planmarks/Splunkerboard/Splunker 1/3D/Render.png

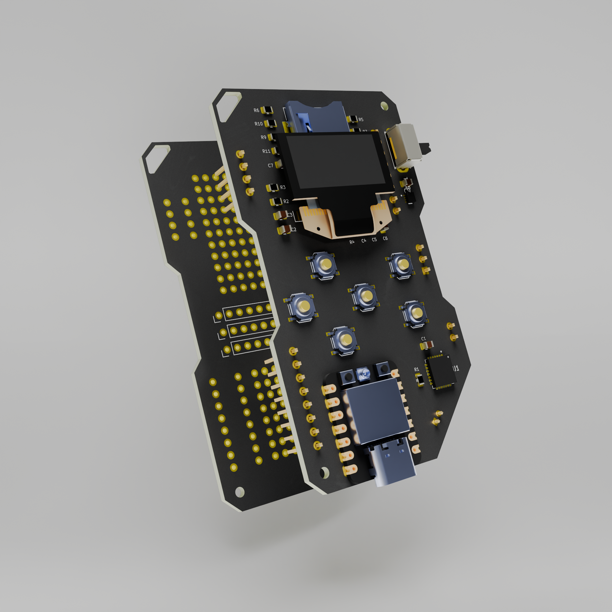
Splunker 1/3D/Render.png
