planmarks/Splunkerboard/Splunker 1/Pictures/Splunkerboard-1-1x1.jpg

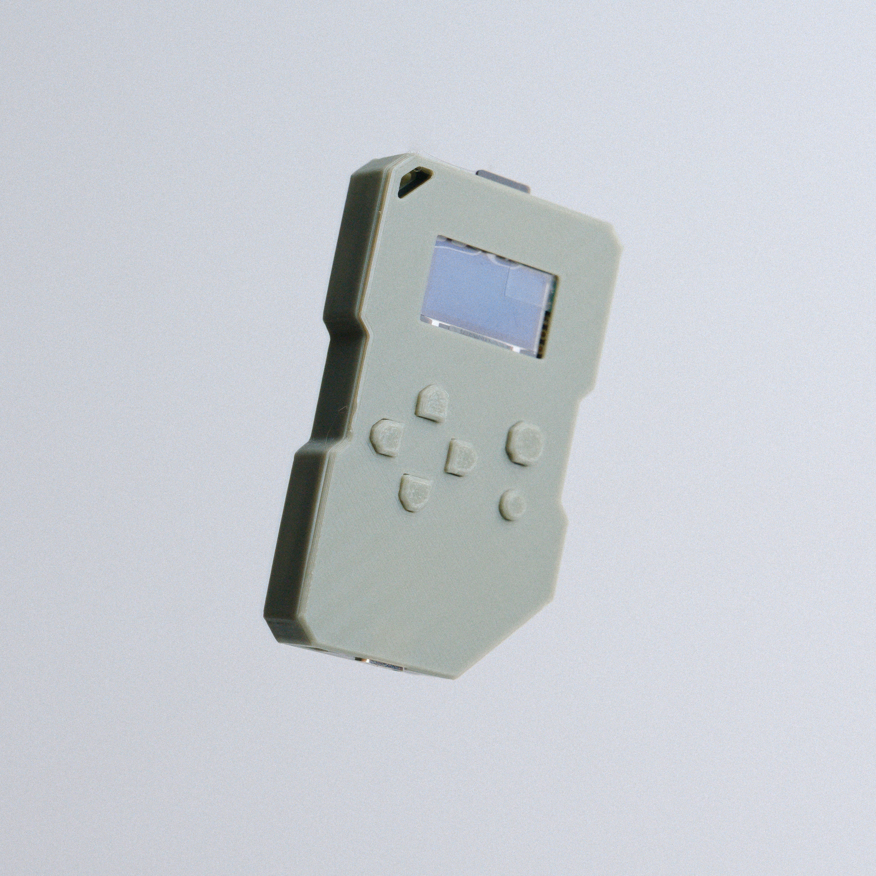
Splunker 1/Pictures/Splunkerboard-1-1x1.jpg
