planmarks/Splunkerboard/Splunker 1/Pictures/splunkerboard-back-1x1.jpg

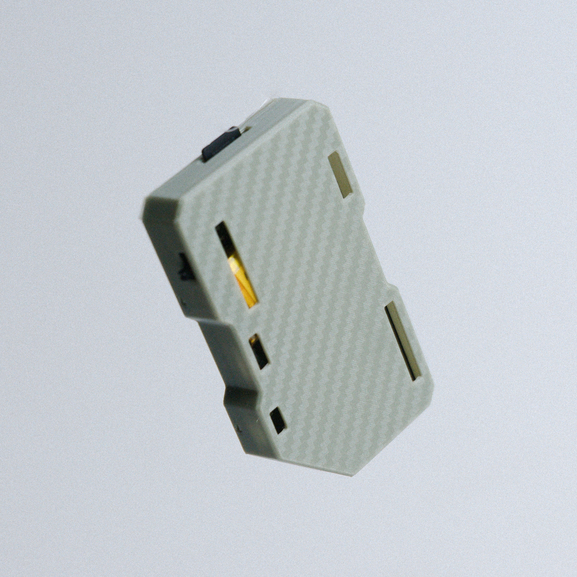
Splunker 1/Pictures/splunkerboard-back-1x1.jpg
