planmarks/Splunkerboard/Splunker 1/Pictures/Splunkerboard-inhand.jpg

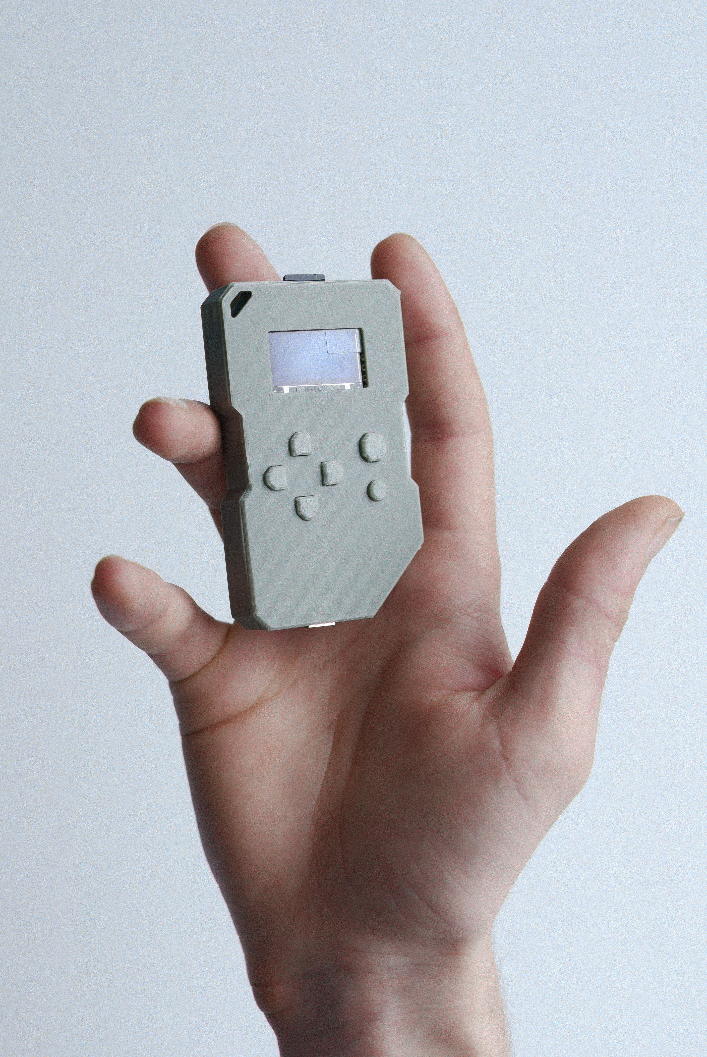
Splunker 1/Pictures/Splunkerboard-inhand.jpg
