planmarks/Splunkerboard/Splunker 1/Pictures/Splunkerboard-naked1x1.jpg

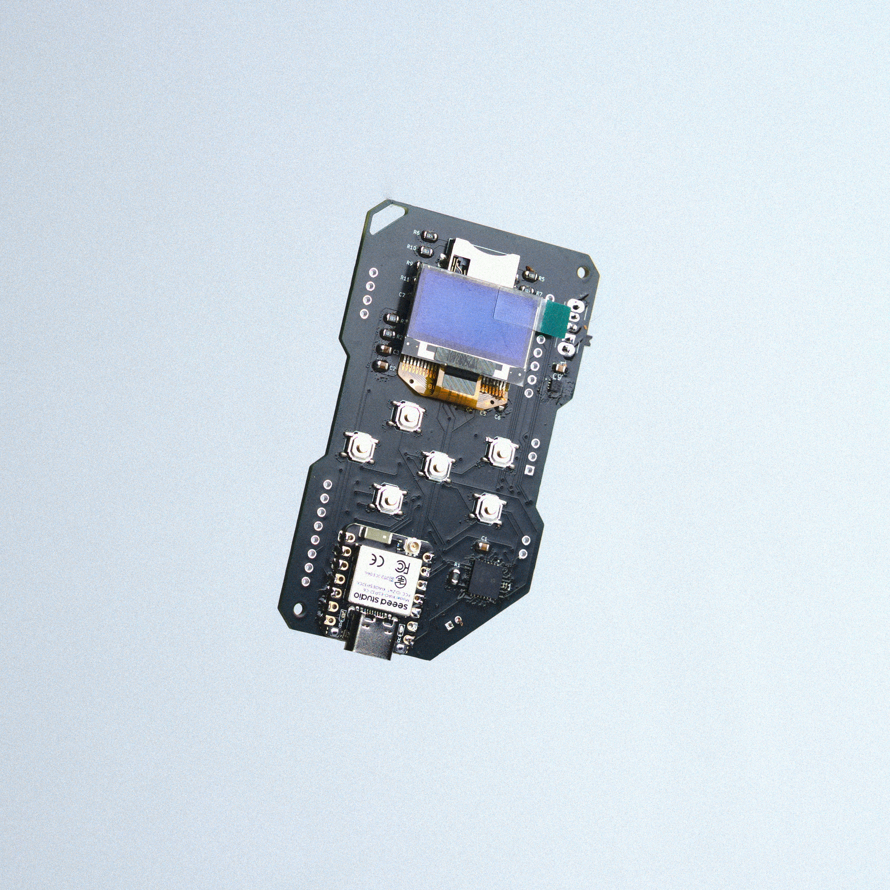
Splunker 1/Pictures/Splunkerboard-naked1x1.jpg
