planmarks/Splunkerboard/Splunker 1/Pictures/Splunkerboard-naked.jpg

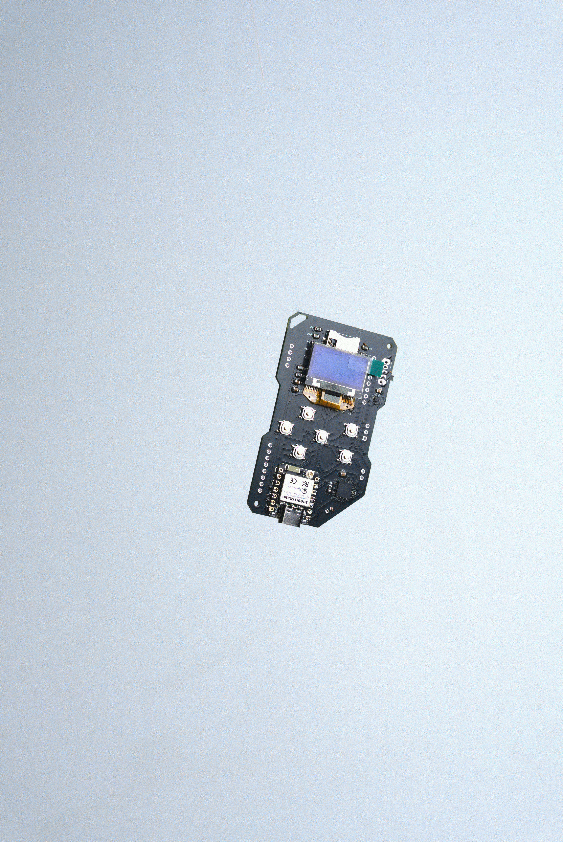
Splunker 1/Pictures/Splunkerboard-naked.jpg
