planmarks/Splunkerboard/Splunker 1/Pictures/Splunkerboard-with-addon1x1.jpg

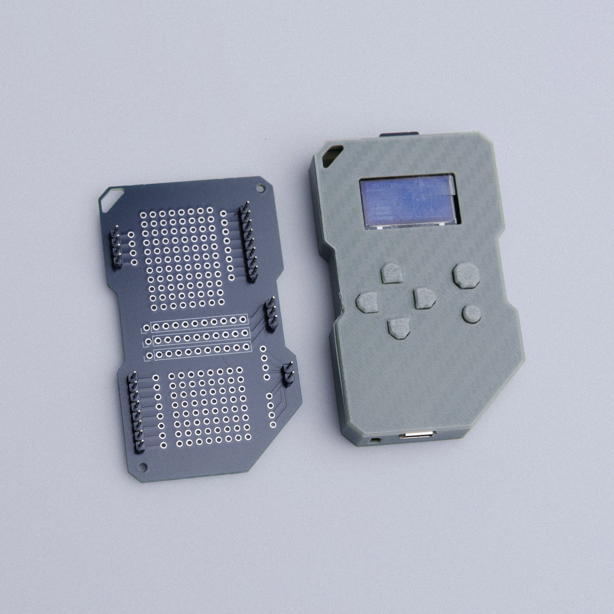
Splunker 1/Pictures/Splunkerboard-with-addon1x1.jpg
