planmarks/Splunkerboard/Splunkerboard DIY/Pictures/Splunkerboard-DIY-2.jpg

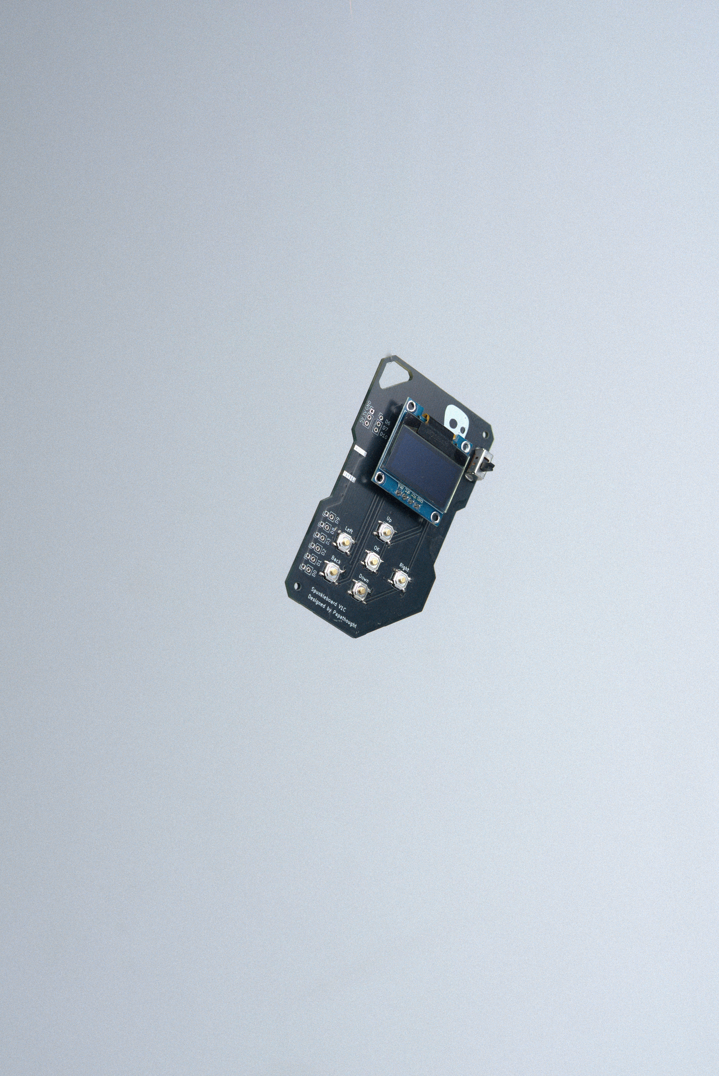
Splunkerboard DIY/Pictures/Splunkerboard-DIY-2.jpg
