planmarks/Splunkerboard/Splunker 1/BOM/Muru Product Compliance - Splunkerboard 1.csv

Reference | Qty | Part nr. / Value | MPN | Footprint | Buy Link 1 | Buy Link 2 | Datasheet | RoHS Comp | RoHS Docs | EMC Test link | CPU | Total Cost
unmarked | 1 | Seeed XIAO ESP32‑C5 | 100010048 |  | https://www.digikey.ee/en/products/detail/seeed-technology-co-ltd/100010048/28959910 |  | https://files.seeedstudio.com/Bazaar/product_pdf/100010048.pdf | ROHS3 Compliant | https://files.seeedstudio.com/Seeed_Certificate/documents_certificate/100010048-ROHS.pdf |  | €6.06 | €6.06
U1 | 1 | MCP23017-EML | MCP23017-E/ML | 28-VQFN Exposed Pad | https://www.digikey.ee/en/products/detail/microchip-technology/MCP23017-E-ML/894270 |  | https://ww1.microchip.com/downloads/aemDocuments/documents/APID/ProductDocuments/DataSheets/MCP23017-Data-Sheet-DS20001952.pdf | ROHS3 Compliant | https://ww1.microchip.com/downloads/aemDocuments/documents/corporate-responsibilty/environmental/product-regulatory-information/Semiconductor_EnvCoC.pdf |  | €1.67 | €1.67
DS1 | 1 | OLED-128O064D | DLC0096DNOG-W-5 |  | https://www.digikey.ee/en/products/detail/dlc-display-co-ltd/dlc0096dnog-w-5/13624832 |  | https://www.dlcdisplay.com/viewfilebizce/1760131013944299520/DLC0096DNOG-W-5.pdf | RoHS Compliant | No public RoHS doc found - request from DLC Display |  | €18.48 | €18.48
J26 | 1 | MicroSD MSD-11-A | MSD-11-A | 10 (8 + 2) | https://www.digikey.ee/en/products/detail/same-sky-formerly-cui-devices/msd-11-a/21798680 |  | https://www.sameskydevices.com/product/resource/msd-11-a.pdf | RoHS Compliant | https://www.sameskydevices.com/product/resource/material-compliance/msd-11-a |  | €0.37 | €0.37
SW2-SW7 | 1 | XKB TS‑1187A tactile switch | PTS526SK15SMTR2 LFS |  | https://www.digikey.ee/en/products/detail/c-k/PTS526SK15SMTR2-LFS/10056626 |  | https://www.littelfuse.com/assetdocs/littelfuse-c-k-tactile-pts526-series-datasheet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 | ROHS3 Compliant | https://www.littelfuse.com/assetdocs/coc-rohs10-08-18-2022?assetguid=6d7cc3c6-97e3-4940-98fc-322868282297 |  | €0.14 | €0.14
SW1 | 1 | CK OS102011MA1Q SPDT slide | OS102011MS2QN1 |  | https://www.digikey.ee/en/products/detail/c-k/OS102011MS2QN1/411602 |  | https://www.littelfuse.com/assetdocs/littelfuse-c-k-slide-os-series-datasheet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 | ROHS3 Compliant | https://www.littelfuse.com/assetdocs/coc-rohs10-08-18-2022?assetguid=6d7cc3c6-97e3-4940-98fc-322868282297 |  | €0.70 | €0.70
U3 | 1 | MAX17048G+T10 | MAX17048G+T10 | 8-WFDFN Exposed Pad | https://www.digikey.ee/en/products/detail/analog-devices-inc-maxim-integrated/MAX17048G-T10/3758921 |  | https://www.analog.com/media/en/technical-documentation/data-sheets/MAX17048-MAX17049.pdf | ROHS3 Compliant | https://www.maximintegrated.com/content/dam/files/design/emmi/rohs-certificate-of-compliance.pdf |  | €4.05 | €4.05
R1 | 1 | 10 K | RMCF0805FT10K0 | 805 | https://www.digikey.ee/en/products/detail/stackpole-electronics-inc/RMCF0805FT10K0/1760676 |  | https://www.seielect.com/catalog/SEI-RMCF_RMCP.pdff | ROHS3 Compliant | https://www.seielect.com/catalog/SEI-RoHS_Compliance_Status.pdf |  | €0.09 | €0.09
R2, R3, R5, R6, R7, R8, R9, R10, R11 | 9 | 4.7 K | RC0805FR-074K7L | 805 | https://www.digikey.ee/en/products/detail/yageo/RC0805FR-074K7L/727929 |  | https://yageogroup.com/content/datasheet/asset/file/PYU-RC_GROUP_51_ROHS_L | ROHS3 Compliant | https://yageogroup.com/content/Resource%20Library/Product%20Environmental%20Compliance/RoHS_Compliance_YAGEO.pdf |  | €0.09 | €0.81
R4 | 1 | 390 K | RC0805JR-07390KL | 805 | https://www.digikey.ee/en/products/detail/yageo/RC0805JR-07390KL/728320 |  | https://yageogroup.com/content/datasheet/asset/file/PYU-RC_GROUP_51_ROHS_L | ROHS3 Compliant | https://yageogroup.com/content/Resource%20Library/Product%20Environmental%20Compliance/RoHS_Compliance_YAGEO.pdf |  | €0.09 | €0.09
C1, C8, C9 | 3 | 0.1 µF | C0805C104K5RACTU | 805 | https://www.digikey.ee/en/products/detail/kemet/C0805C104K5RACTU/411169 |  | https://yageogroup.com/content/datasheet/asset/file/KEM_C1002_X7R_SMD | ROHS3 Compliant | https://yageogroup.com/component-documentation/download/rohs/C0805C104K5RACTU.pdf |  | €0.16 | €0.48
C7 | 1 | 10 µF | C0805C106K8PACTU | 805 | https://www.digikey.ee/en/products/detail/kemet/C0805C106K8PACTU/1090830 |  | https://yageogroup.com/content/datasheet/asset/file/KEM_C1006_X5R_SMD | ROHS3 Compliant | https://yageogroup.com/component-documentation/download/rohs/C0805C106K8PACTU.pdf |  | €0.18 | €0.18
C2, C3, C6 | 3 | 2.2 µF | UMK212BB7225KG-T | 805 | https://www.digikey.ee/en/products/detail/taiyo-yuden/UMK212BB7225KG-T/3194965 | https://www.mouser.ee/en/ProductDetail/Walsin/0805B225K100CT | https://mm.digikey.com/Volume0/opasdata/d220001/medias/docus/992/UMK212BB7225KG-T_SS.pdf | ROHS3 Compliant | https://www.yuden.co.jp/en/product/certificate/upload/MLCC-RoHS.pdf |  | €0.28 | €0.84
C4 | 1 | 1 µF | CAP CER 10000PF 50V X7R 0603 | 805 | https://www.digikey.ee/en/products/detail/samsung-electro-mechanics/CL10B103KB8NNNC/3886667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 |  | https://mm.digikey.com/Volume0/opasdata/d220001/medias/docus/609/CL10B103KB8NNNC_Spec.pdf | ROHS3 Compliant | https://www.samsungsem.com/files/fileDown.do?key=ed1dfdfa-645e-4252-b707-17f9b1502dd1 |  | €0.09 | €0.09
C5 | 1 | 0.1 µF | C0805C104K5RACTU | 805 | https://www.digikey.ee/en/products/detail/kemet/C0805C104K5RACTU/411169 |  | https://yageogroup.com/content/datasheet/asset/file/KEM_C1002_X7R_SMD | ROHS3 Compliant | https://yageogroup.com/component-documentation/download/rohs/C0805C104K5RACTU.pdf |  | €0.16 | €0.16
 |  |  |  |  |  |  |  |  |  |  | €0.50 | €0.50
 |  |  |  |  |  |  |  |  |  |  | €5.00
 |  |  |  |  |  |  |  |  |  |  | Total | €34.71
