planmarks/Splunkerboard/Splunker 1 Prototyping Board/3D/Splunkerboard.stl

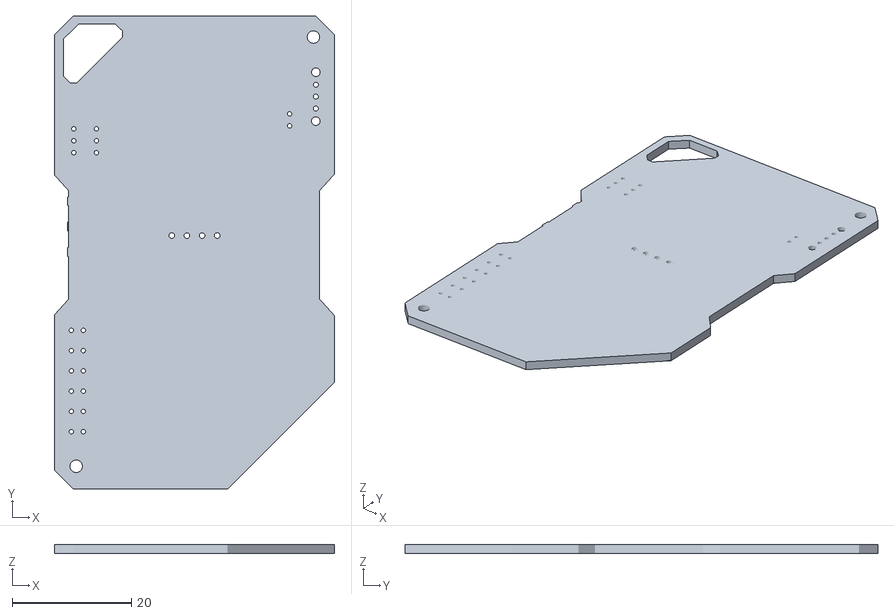
[picture p12: CAD file, 2026-10-02]
Splunker 1 Prototyping Board/3D/Splunkerboard.stl
47.0 x 79.3 x 1.66
