planmarks/Splunkerboard/Splunker 1/Case/v01/Splunkerboard CaseCylinder.stl

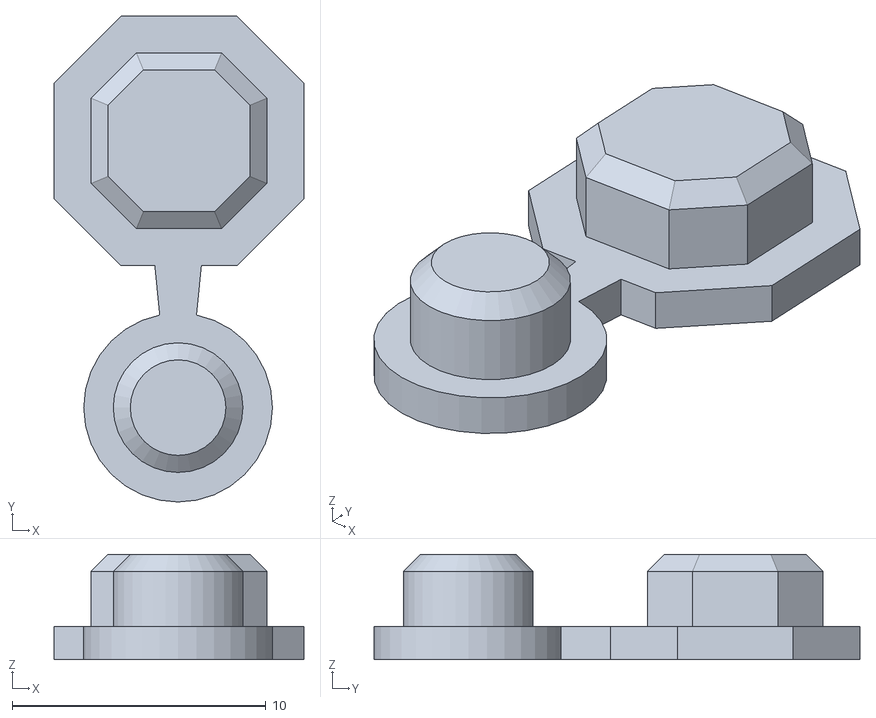
[picture p13: CAD file, 2026-10-26]
Splunker 1/Case/v01/Splunkerboard CaseCylinder.stl
9.83 x 19.1 x 4.15
