planmarks/Splunkerboard/Splunker 1/Case/v01/Splunkerboard CaseCase_Top.stl

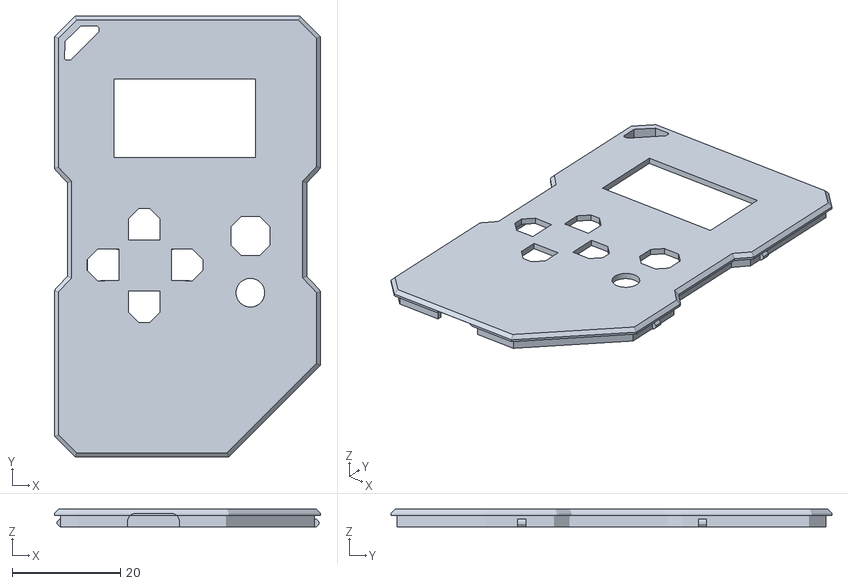
[picture p14: CAD file, 2026-10-26]
Splunker 1/Case/v01/Splunkerboard CaseCase_Top.stl
49.2 x 81.5 x 3.32
