planmarks/Splunkerboard/Splunker 1/Case/v01/Splunkerboard CaseCase_Bottom_Batter.stl

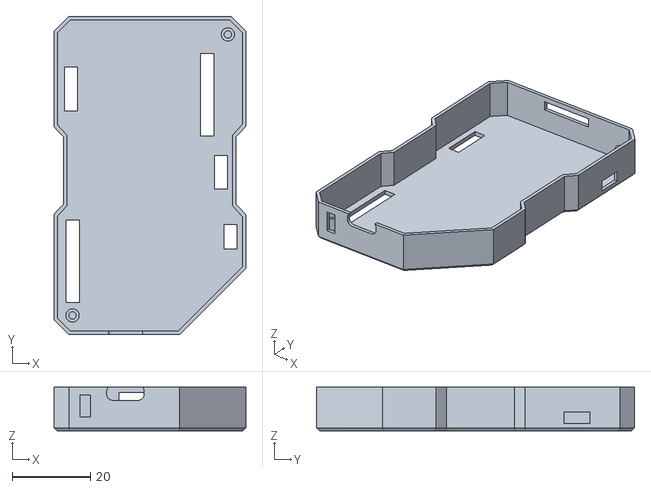
[picture p15: CAD file, 2026-10-26]
Splunker 1/Case/v01/Splunkerboard CaseCase_Bottom_Batter.stl
49.2 x 81.5 x 11.3
