planmarks/Splunkerboard/Splunker 1/Case/v01/Splunkerboard CaseCube.002.stl

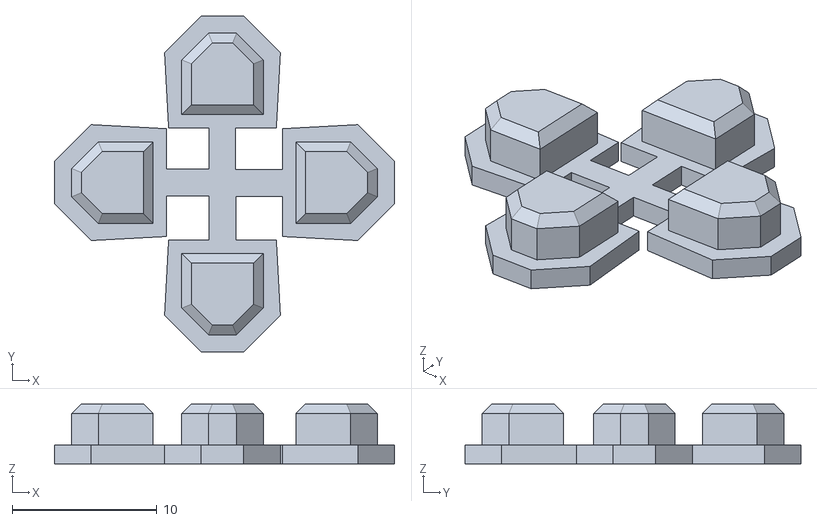
[picture p16: CAD file, 2026-10-26]
Splunker 1/Case/v01/Splunkerboard CaseCube.002.stl
23.5 x 23.2 x 4.15
