planmarks/Splunkerboard/(list of files, cad)

Other CAD files:
Splunker 1/3D/Splunkerboard Dev.stl
Splunker 1/Case/v0/Splunkerboard CaseCase_Bottom_Batter.stl
Splunker 1/Case/v0/Splunkerboard CaseCase_Top.stl
Splunker 1/3D/Spunkleboard 1 3D.blend
Splunker 1/Case/Splunkerboard Case.blend
