planmarks/Splunkerboard/Splunkerboard DIY/Spunkleboard.kicad_pcb

## KiCad design Splunkerboard DIY/Spunkleboard.kicad_pcb (2026-10-02)

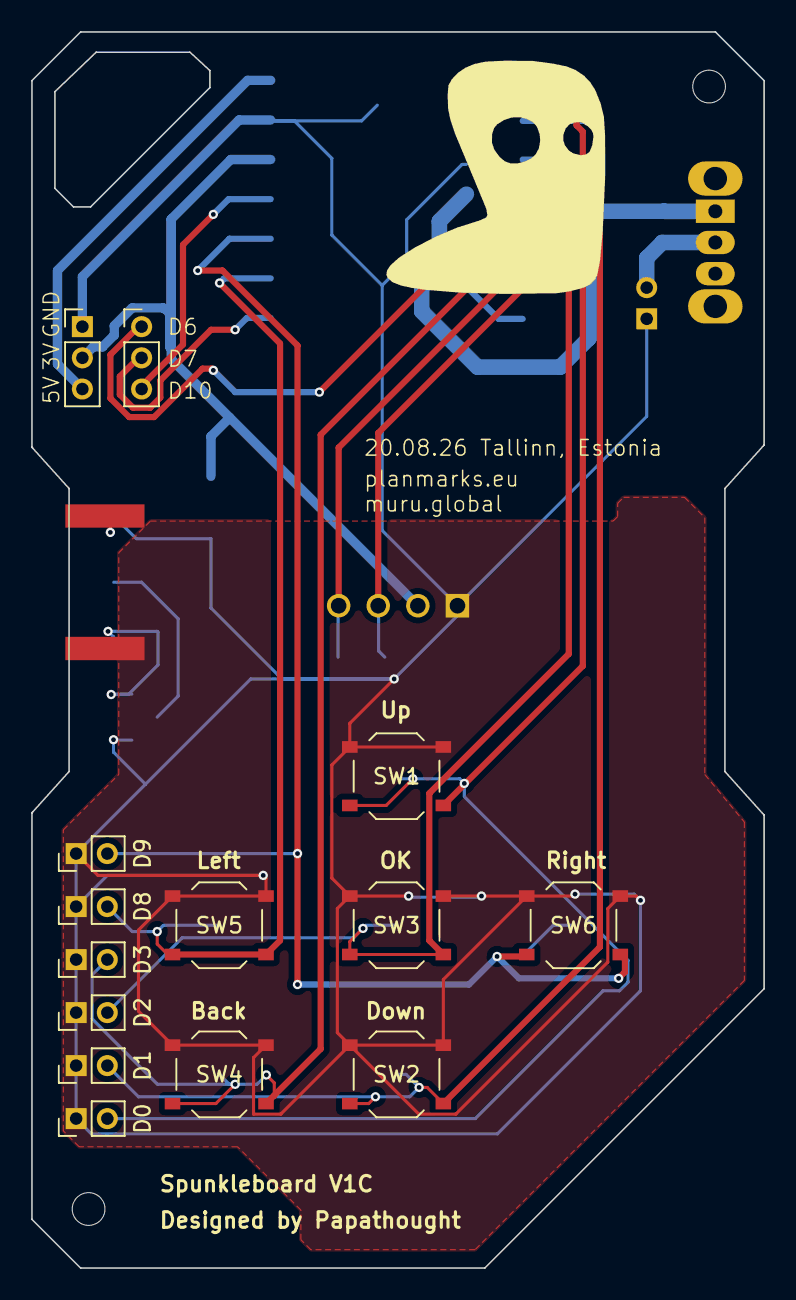
[picture p17: board Splunkerboard DIY/Spunkleboard.kicad_pcb from above]

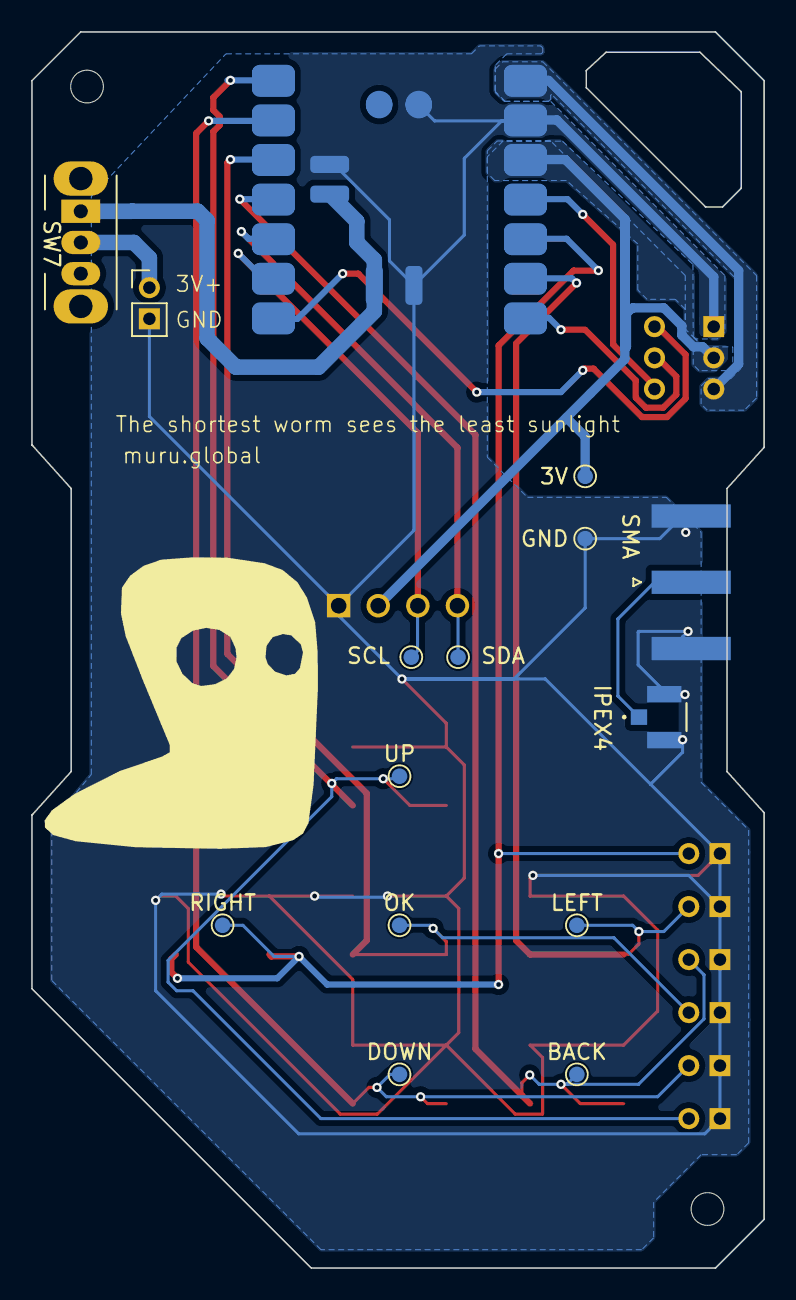
[picture p18: board Splunkerboard DIY/Spunkleboard.kicad_pcb from below]

Board: 2 copper layers, 47.0 x 79.3 mm, 31 parts (16 on the bottom side), 18 nets.

Parts:
3V: 3V3; TestPoint_Pad_D1.0mm
BACK: SW-BCK; TestPoint_Pad_D1.0mm
BT1: Battery; PinHeader_1x02_P2.00mm_Vertical
D0, D1, D2, D3, D8, D9: PinHeader_1x02_P2.00mm_Vertical
DOWN: SW-DWN; TestPoint_Pad_D1.0mm
GND: GND; TestPoint_Pad_D1.0mm
IPEX4: MHF_I_RECE_IPX; MHF I_RECE_IPX
LEFT: SW-LFT; TestPoint_Pad_D1.0mm
MNT: MountingHole_2.1mm
MNT#2: MountingHole_2.1mm
OK: SW-OK; TestPoint_Pad_D1.0mm
RIGHT: SW-RHT; TestPoint_Pad_D1.0mm
SCL: SCL; TestPoint_Pad_D1.0mm
SDA: SDA; TestPoint_Pad_D1.0mm
SMA: SMA_Amphenol_132289_EdgeMount
SW1: SW_Push UP; SW_Push_1P1T_XKB_TS-1187A
SW2: SW_Push DOWN; SW_Push_1P1T_XKB_TS-1187A
SW3: SW_Push OK; SW_Push_1P1T_XKB_TS-1187A
SW4: SW_Push BACK; SW_Push_1P1T_XKB_TS-1187A
SW5: SW_Push LEFT; SW_Push_1P1T_XKB_TS-1187A
SW6: SW_Push RIGHT; SW_Push_1P1T_XKB_TS-1187A
SW7: SW_SPDT; SW_Slide_SPDT_Angled_CK_OS102011MA1Q
U1: XIAO-ESP32-C5-SMD
U2: DM-OLED096-636; MODULE_DM-OLED096-636
U3: XIAO-ESP32-C3-SMD
UP: SW-UP; TestPoint_Pad_D1.0mm

Connections:
+3.3V: 3V.1 (1_1), U1.12 (3V3_OUT), U2.2 (VCC_IN), U3.12 (3V3_OUT)
BAT+: BT1.1 (+), SW7.2 (B)
D0-SW1: D0.2, SW1.2, U1.1 (D0), U3.1 (D0), UP.1 (1_1)
D1-SW2: D1.2, DOWN.1 (1_1), SW2.2, U1.2 (D1), U3.2 (D1)
D2-SW3: D2.2, OK.1 (1_1), SW3.2, U1.3 (D2), U3.3 (D2)
D3-SW4: BACK.1 (1_1), D3.2, SW4.2, U1.4 (D3), U3.4 (D3)
D4-SDA: SDA.1 (1_1), U1.5 (D4), U2.4 (SDA), U3.5 (D4)
D5-SCL: SCL.1 (1_1), U1.6 (D5), U2.3 (SCL), U3.6 (D5)
D6: U1.7 (D6), U3.7 (D6)
D7: U1.8 (D7), U3.8 (D7)
D8-SW5: D8.2, LEFT.1 (1_1), SW5.2, U1.9 (D8), U3.9 (D8)
D9-SW6: D9.2, RIGHT.1 (1_1), SW6.2, U1.10 (D9), U3.10 (D9/BOOT)
D10: U1.11 (D10), U3.11 (D10)
EN: U1.17 (EN), U3.17 (EN)
GND: BT1.2 (-), D0.1, D1.1, D2.1, D3.1, D8.1, D9.1, GND.1 (1_1), IPEX4.1, IPEX4.2, SMA.2, SW1.1, SW2.1, SW3.1, SW4.1, SW5.1, SW6.1, U1.13 (GND), U1.18 (GND), U1.24 (GND), U2.1 (GND), U3.13 (GND), U3.18 (GND), U3.22 (GND)
IPEX: IPEX4.3, SMA.1
VBAT: SW7.1 (A), U1.23 (VBAT), U3.21 (VBAT)
VBUS: U1.14 (VBUS), U3.14 (VBUS)
