planmarks/Splunkerboard/Splunker 1 Prototyping Board/Spunkleboard.kicad_pcb

## KiCad design Splunker 1 Prototyping Board/Spunkleboard.kicad_pcb (2026-10-02)

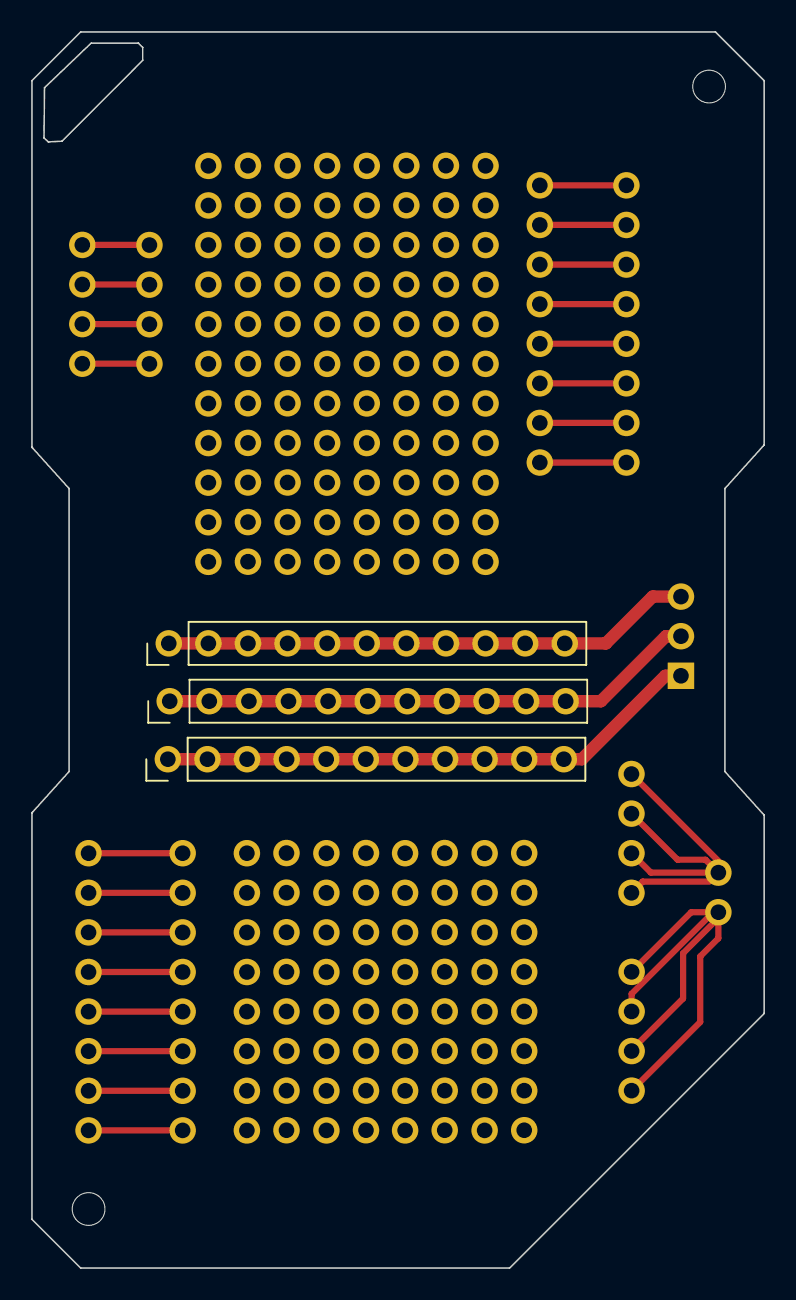
[picture p19: board Splunker 1 Prototyping Board/Spunkleboard.kicad_pcb from above]

Board: 4 copper layers, 47.0 x 79.3 mm, 5 parts (0 on the bottom side), 3 nets.

Parts:
3V, 5V: PinHeader_1x11_P2.54mm_Vertical
GND: PinHeader_1x11_P2.54mm_Vertical
MNT: MountingHole_2.1mm
MNT#2: MountingHole_2.1mm

Connections:
+3V3: 3V.1, 3V.2, 3V.3, 3V.4, 3V.5, 3V.6, 3V.7, 3V.8, 3V.9, 3V.10, 3V.11
GND: GND.1, GND.2, GND.3, GND.4, GND.5, GND.6, GND.7, GND.8, GND.9, GND.10, GND.11
VBUS: 5V.1, 5V.2, 5V.3, 5V.4, 5V.5, 5V.6, 5V.7, 5V.8, 5V.9, 5V.10, 5V.11
