planmarks/Splunkerboard/Splunker 1/Spunkleboard.kicad_pcb

## KiCad design Splunker 1/Spunkleboard.kicad_pcb (2026-10-02)

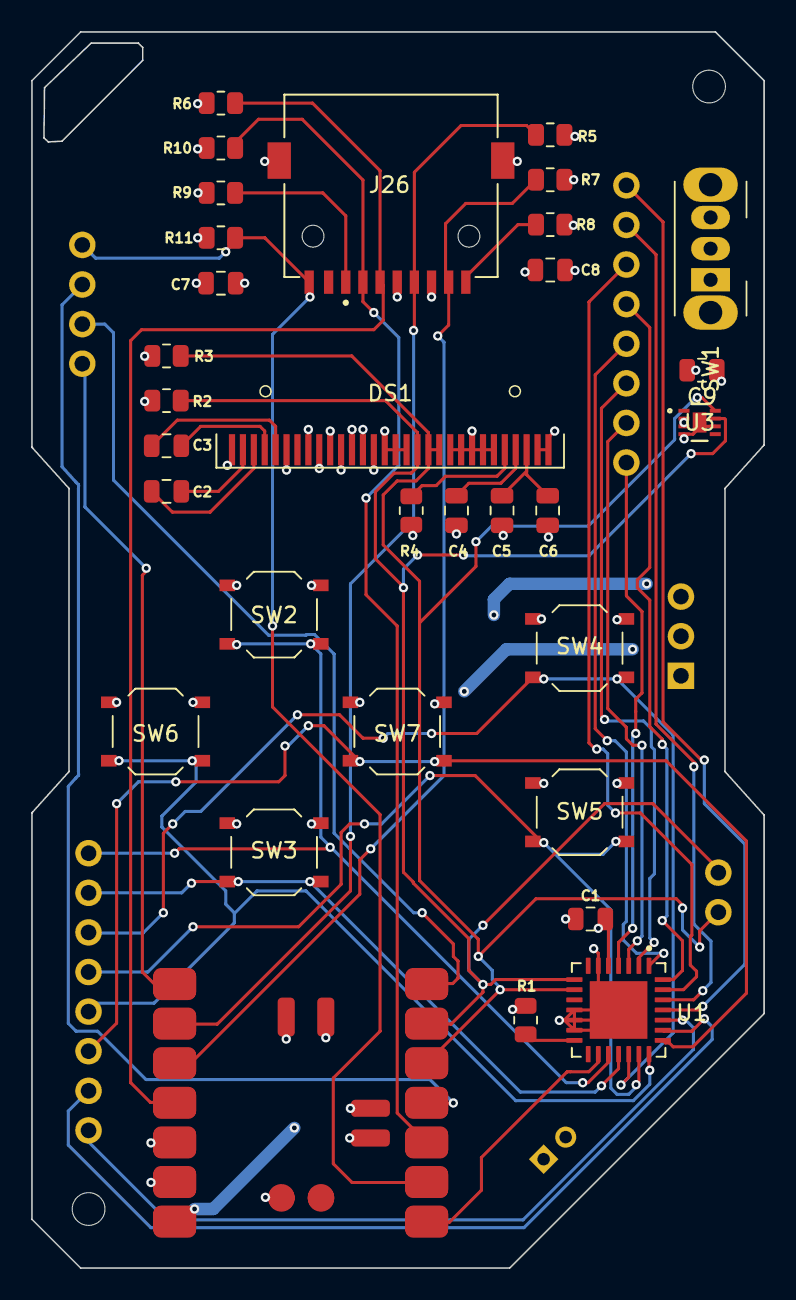
[picture p20: board Splunker 1/Spunkleboard.kicad_pcb from above]

Board: 4 copper layers, 47.0 x 79.3 mm, 36 parts (1 on the bottom side), 33 nets.

Parts:
BT1: Battery; PinHeader_1x02_P2.00mm_Vertical
C1, C5, C8, C9: 0.1uF; C_0805_2012Metric
C2, C3: 2.2 µF; C_0805_2012Metric
C4: 1uF; C_0805_2012Metric
C6: 2uF; C_0805_2012Metric
C7: 10uF; C_0805_2012Metric
DS1: OLED-128O064D
J26: MSD-11-A; CUI_MSD-11-A
MNT: MountingHole_2.1mm
MNT#2: MountingHole_2.1mm
R1: 10K; R_0805_2012Metric
R2, R3, R5, R6, R7, R8, R9, R10, R11: 4.7K; R_0805_2012Metric
R4: 390K; R_0805_2012Metric
SW1: SW_SPDT; SW_Slide_SPDT_Angled_CK_OS102011MA1Q
SW2: SW_Push UP; SW_Push_1P1T_XKB_TS-1187A
SW3: SW_Push DOWN; SW_Push_1P1T_XKB_TS-1187A
SW4: SW_Push OK; SW_Push_1P1T_XKB_TS-1187A
SW5: SW_Push BACK; SW_Push_1P1T_XKB_TS-1187A
SW6: SW_Push LEFT; SW_Push_1P1T_XKB_TS-1187A
SW7: SW_Push RIGHT; SW_Push_1P1T_XKB_TS-1187A
U1: XIAO-ESP32-C5-SMD
U1#2: MCP23017-EML; QFN65P600X600X100-29N
U3: MAX17048G+T10; 21-0168E_T822-3_MXM
U3#2: XIAO-ESP32-C3-SMD

Connections:
+3V3: C1.2, C7.1, C8.1, DS1.6 (VBAT), DS1.9 (VDD), DS1.11 (BS1), DS1.14 (~RES), J26.P4 (VDD), R1.1, R2.1, R3.1, R5.2, R6.2, R7.2, R8.2, R9.2, R10.2, R11.2, U1.12 (3V3_OUT), U1#2.5 (VDD), U3#2.12 (3V3_OUT)
D0-INTA: U1.1 (D0), U1#2.16 (INTA), U3#2.1 (D0)
D1: J26.CD, R11.1, U1.2 (D1), U3#2.2 (D1)
D2-SDCS: J26.P2 (CD/DAT3), R10.1, U1.3 (D2), U3#2.3 (D2)
D3: U1.4 (D3), U3#2.4 (D3)
D4-SDA: DS1.19 (D1), DS1.20 (D2), R3.2, U1.5 (D4), U1#2.9 (SDA), U3.8 (SDA), U3#2.5 (D4)
D5-SCL: DS1.18 (D0), R2.2, U1.6 (D5), U1#2.8 (SCK), U3.7 (SCL), U3#2.6 (D5)
D6: U1.7 (D6), U3#2.7 (D6)
D7: U1.8 (D7), U3#2.8 (D7)
D8-SDCLK: J26.P5 (CLK), R5.1, U1.9 (D8), U3#2.9 (D8)
D9-SDSO: J26.P7 (DAT0), R7.1, U1.10 (D9), U3#2.10 (D9/BOOT)
D10-SDSI: J26.P3 (CMD), R6.1, U1.11 (D10), U3#2.11 (D10)
EN: U1.17 (EN), U3#2.17 (EN)
GND: BT1.2 (-), C1.1, C4.2, C5.2, C6.2, C7.2, C8.2, C9.1, DS1.1 (GND), DS1.8 (VSS), DS1.10 (BS0), DS1.12 (BS2), DS1.13 (~CS), DS1.15 (D/~C), DS1.16 (R/~W), DS1.17 (E/~RD), DS1.21 (D3), DS1.22 (D4), DS1.23 (D5), DS1.24 (D6), DS1.25 (D7), DS1.29 (VLSS), DS1.30 (GND), J26.G1 (COVER_GND), J26.G2 (COVER_GND), J26.P6 (VSS), R4.1, SW2.1, SW3.1, SW4.1, SW5.1, SW6.1, SW7.1, U1.13 (GND), U1.18 (GND), U1.24 (GND), U1#2.6 (VSS), U1#2.11 (A0), U1#2.12 (A1), U1#2.13 (A2), U1#2.29 (EXP), U3.4 (GND), U3.6 (QSTRT), U3.9 (EPAD), U3#2.13 (GND), U3#2.18 (GND), U3#2.22 (GND)
unnamed: C3.1, DS1.5 (C1N)
unnamed: C3.2, DS1.4 (C1P)
unnamed: C2.2, DS1.2 (C2N)
unnamed: C2.1, DS1.3 (C2P)
unnamed: DS1.26 (IREF), R4.2
unnamed: C5.1, C6.1, DS1.28 (VCC)
unnamed: C4.1, DS1.27 (VCOMH)
unnamed: J26.P8 (DAT1), R8.1
unnamed: J26.P1 (DAT2), R9.1
unnamed: R1.2, U1#2.14 (~RESET)
PWR: SW1.2 (B), U1.23 (VBAT), U3#2.21 (VBAT)
SW2-GPA0: SW2.2, U1#2.17 (GPA0)
SW3-GPA1: SW3.2, U1#2.18 (GPA1)
SW4-GPA2: SW4.2, U1#2.19 (GPA2)
SW5-GPA3: SW5.2, U1#2.20 (GPA3)
SW6-GPA4: SW6.2, U1#2.21 (GPA4)
SW7-GPA5: SW7.2, U1#2.22 (GPA5)
VBAT: BT1.1 (+), C9.2, SW1.3 (C), U3.2 (CELL), U3.3 (VDD)
VBUS: U1.14 (VBUS), U3#2.14 (VBUS)
