planmarks/Splunkerboard/(commit log)

2026-10-02 Initial commit: Splunkerboard hardware, firmware and docs
    [Splunkerboard Case.blend, Splunkerboard Dev.stl, Splunkerboard.stl, Spunkleboard 1 3D.blend, Spunkleboard.kicad_pcb, Spunkleboard.kicad_sch]
2026-10-26 Small update
    [Muru Product Compliance - Splunkerboard 1.csv, Splunkerboard Case.blend, Splunkerboard CaseCase_Bottom_Batter.stl, Splunkerboard CaseCase_Top.stl, Splunkerboard CaseCube.002.stl, Splunkerboard CaseCylinder.stl, Spunkleboard 1 3D.blend]
